QuangT411/DA1_HUST/README.md

# DA1_HUST
Introduction:
This project by students at the School of Electrical–Electronics, Hanoi University of Science and Technology, develops an IoT system to monitor salt intrusion in coastal and downstream areas.

Features:
Real-time EC measurement.
Temperature compensation with DS18B20.
Automatic alerts when thresholds are exceeded.
Data storage on Firebase and SD Card.
Web interface to view sensor location and history.

Components:
LGT8F328P microcontroller, EC sensor, DS18B20, WiFi, OLED, SD Card, Firebase.
